jbeuckm/atmega_midi_SP0256-AL2/panel/speech_synth_panel.dxf

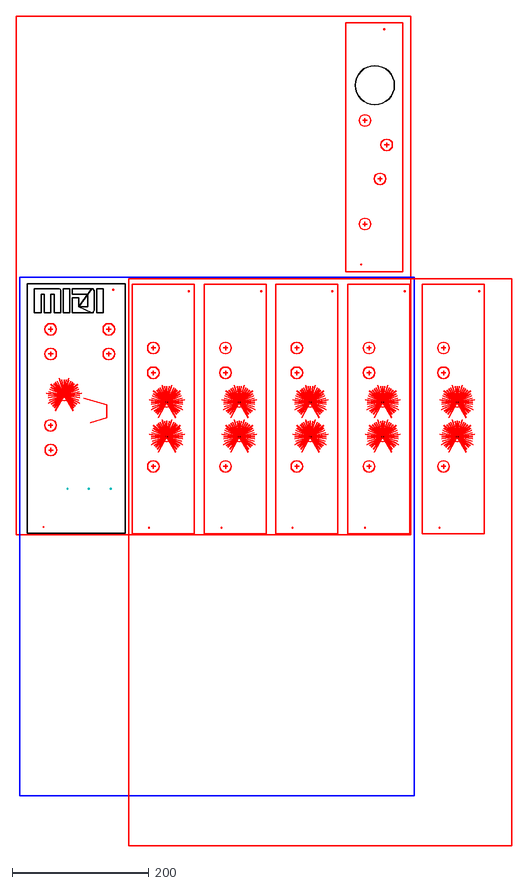
[picture p2: CAD file, 2016-11-26]
panel/speech_synth_panel.dxf
723.2 x 1211.1
