jbeuckm/atmega_midi_SP0256-AL2/panel/speech_synth_panel.pdf

# Speech

# gate

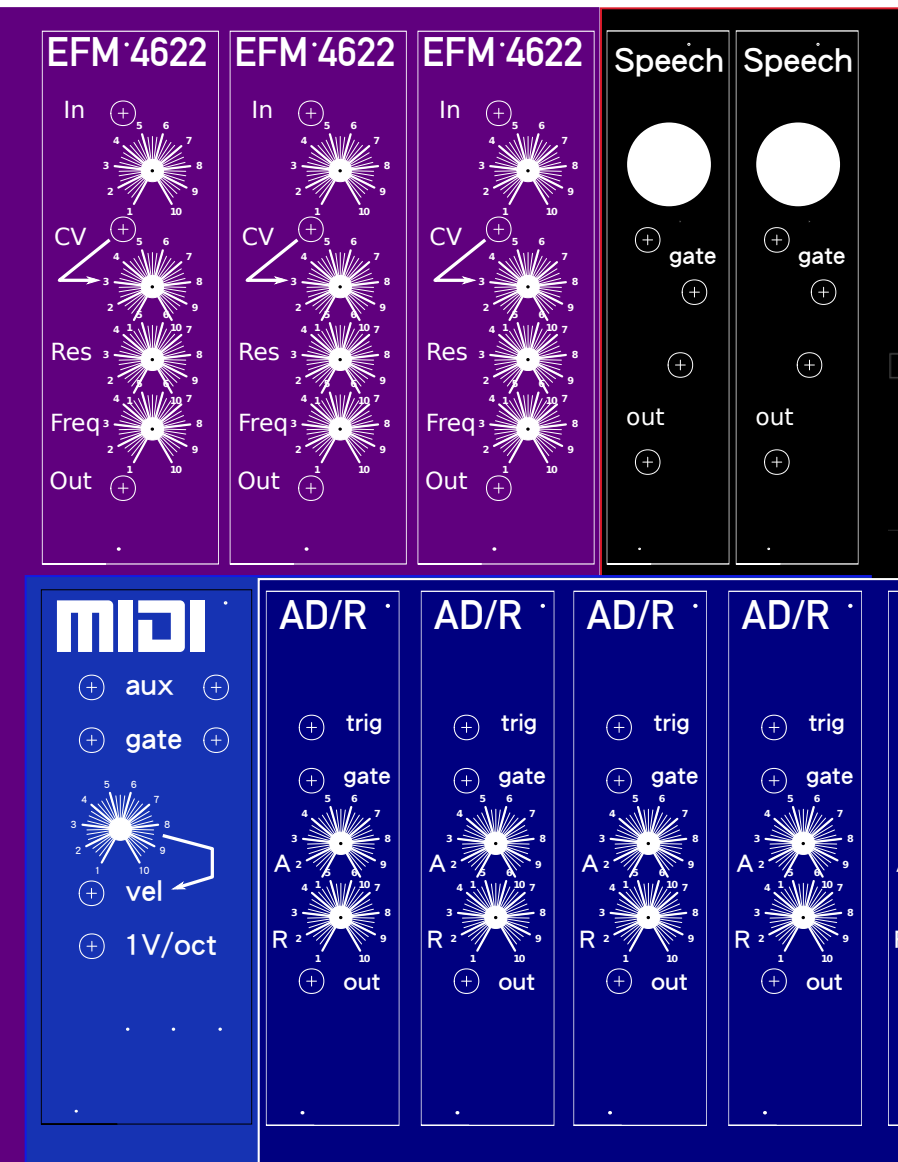
[picture p3: page 1]
out; vel; 1V/oct; gate; aux; trig; EFM 4622; Out; Res; Freq; Speech
