jbeuckm/atmega_midi_SP0256-AL2/eagle/atmega_midi_SP0256-AL2.brd

## EAGLE design eagle/atmega_midi_SP0256-AL2.brd (2016-11-26)

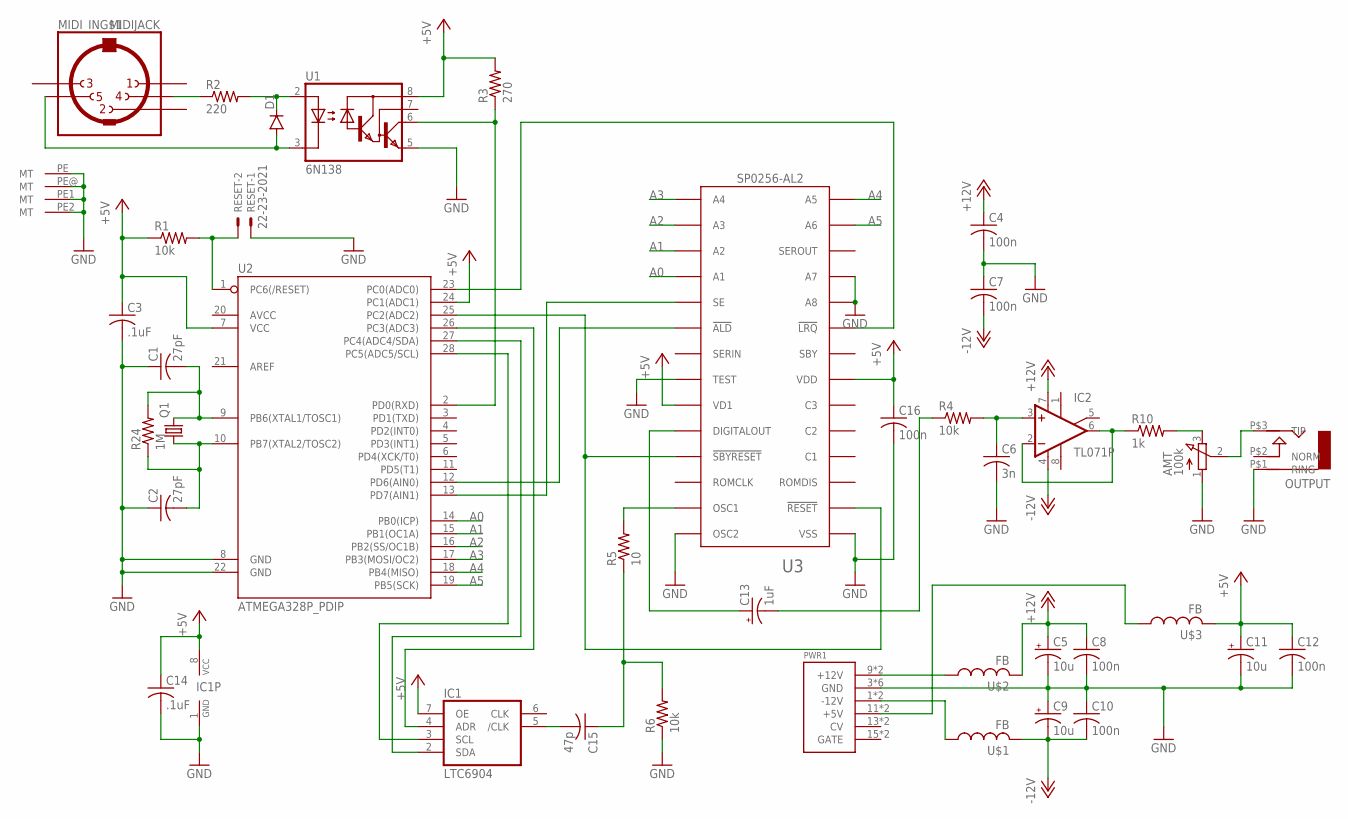
[picture p4: schematic atmega_midi_SP0256-AL2.sch]

Parts:
AMT: 100k; 3RP/1610N
C1, C2: 27pF; C025-040X050
C3, C14: .1uF; C025-030X050
C4: 100n; C050-024X044
C5, C9, C11: 10u; B45181A
C6: 3n; C050-024X044
C7, C8, C10, C12, C16: 100n; C025-030X050
C13: 1uF; E15-6
C15: 47p; C050-024X044
D1: DIODE1N4148; DIODE-1N4148
IC1: LTC6904; DIL08
IC2: TL071P; DIL08
MIDI_IN: MIDIJACK; CP-2350
OUTPUT: AUDIO-JACK; ERTHENVAR-JACK-90DEG
PWR1: POWER; POWER_16
Q1: CRYSTALHC49S; HC49/S
R1, R4, R6: 10k; 0207/7
R2: 220; 0207/7
R3: 270; 0207/7
R5: 10; 0207/7
R10: 1k; 0207/7
R24: 1M; 0207/7
RESET: 22-23-2021
U1: 6N138; DIL08
U2: ATMEGA328P_PDIP; DIL28-3
U3: SP0256-AL2; DIL28-6
U$1, U$2, U$3: FB

Connections:
+5V: C3.1, C11.+, C12.1, C14.1, C16.1, IC1.7 (OE), IC1.8 (VCC), R1.1, R3.2, U1.8 (VCC), U2.7 (VCC), U2.24 (PC1(ADC1)), U3.P$7 (VDD), U3.P$23 (VD1), U$3.P$2 (2)
+12V: C4.1, C5.+, C8.1, IC2.7 (V+), U$2.P$2 (2)
-12V: C7.2, C9.-, C10.2, IC2.4 (V-), U$1.P$2 (2)
A0: U2.14 (PB0(ICP)), U3.P$18 (A1)
A1: U2.15 (PB1(OC1A)), U3.P$17 (A2)
A2: U2.16 (PB2(SS/OC1B)), U3.P$16 (A3)
A3: U2.17 (PB3(MOSI/OC2)), U3.P$15 (A4)
A4: U2.18 (PB4(MISO)), U3.P$14 (A5)
A5: U2.19 (PB5(SCK)), U3.P$13 (A6)
GND: AMT.1 (A), C1.1, C2.1, C3.2, C4.2, C5.-, C6.2, C7.1, C8.2, C9.+, C10.1, C11.-, C12.2, C14.2, C16.2, IC1.1 (GND), MIDI_IN.PE (MT), MIDI_IN.PE1 (MT), MIDI_IN.PE2 (MT), MIDI_IN.PE@ (MT), OUTPUT.P$1 (RING), PWR1.3 (GND), PWR1.4 (GND), PWR1.5 (GND), PWR1.6 (GND), PWR1.7 (GND), PWR1.8 (GND), R6.1, RESET.1, U1.5 (GND), U2.8 (GND), U2.22 (GND), U3.P$1 (VSS), U3.P$10 (A8), U3.P$11 (A7), U3.P$22 (TEST), U3.P$28 (OSC2)
unnamed: U2.25 (PC2(ADC2)), U3.P$2 (!RESET), U3.P$25 (!SBYRESET)
unnamed: PWR1.11 (+5V), PWR1.12 (+5V), U$3.P$1 (1)
unnamed: D1.A, MIDI_IN.5, U1.3 (C)
unnamed: C1.2, Q1.2, R24.2, U2.9 (PB6(XTAL1/TOSC1))
unnamed: C2.2, Q1.1, R24.1, U2.10 (PB7(XTAL2/TOSC2))
unnamed: C6.1, IC2.3 (+IN), R4.2
unnamed: D1.C, R2.2, U1.2 (A)
unnamed: MIDI_IN.4, R2.1
unnamed: AMT.3 (E), R10.2
unnamed: U2.12 (PD6(AIN0)), U3.P$20 (!ALD)
unnamed: PWR1.9 (+12V), PWR1.10 (+12V), U$2.P$1 (1)
unnamed: IC2.2 (-IN), IC2.6 (OUT), R10.1
unnamed: AMT.2 (S), OUTPUT.P$3 (TIP)
unnamed: PWR1.1 (-12V), PWR1.2 (-12V), U$1.P$1 (1)
unnamed: IC1.3 (SCL), U2.28 (PC5(ADC5/SCL))
unnamed: U2.13 (PD7(AIN1)), U3.P$19 (SE)
unnamed: C13.+, U3.P$24 (DIGITALOUT)
unnamed: IC1.2 (SDA), U2.27 (PC4(ADC4/SDA))
unnamed: IC1.4 (ADR), U2.26 (PC3(ADC3))
unnamed: U2.23 (PC0(ADC0)), U3.P$9 (!LRQ)
unnamed: C15.2, IC1.5 (/CLK)
unnamed: R3.1, U1.6 (VO), U2.2 (PD0(RXD))
unnamed: C13.-, R4.1
unnamed: R5.2, U3.P$27 (OSC1)
unnamed: C15.1, R5.1, R6.2
unnamed: R1.2, RESET.2, U2.1 (PC6(/RESET))

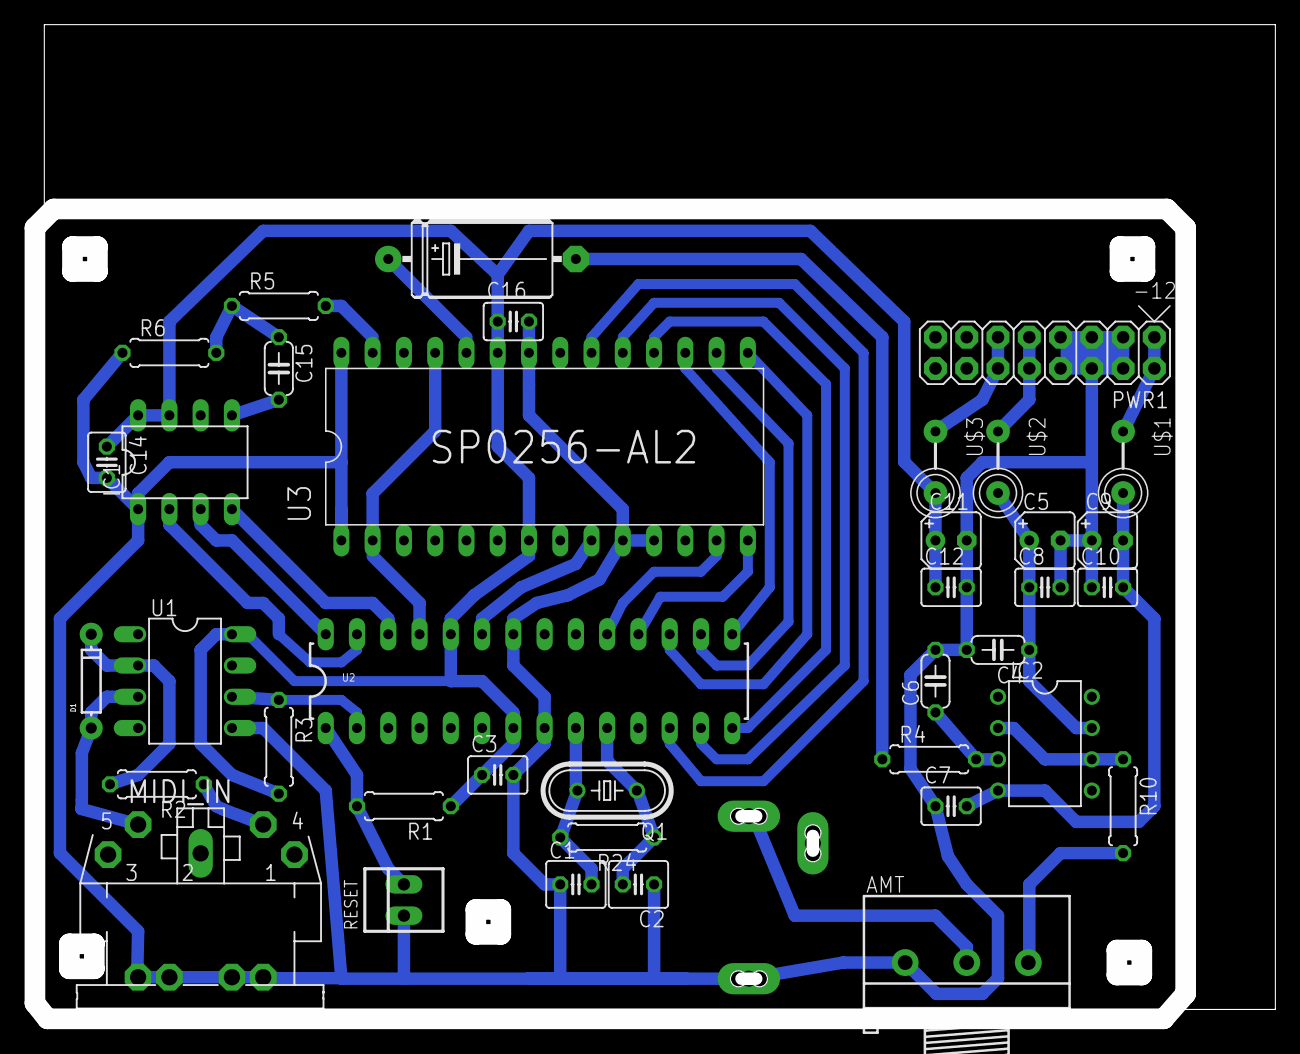
[picture p5: board atmega_midi_SP0256-AL2.brd from above]

Board: 2 copper layers, 100.8 x 80.8 mm, 39 parts (0 on the bottom side), 36 nets.
