jbeuckm/atmega_midi_SP0256-AL2/atmega_midi_sp0256/SP0256.cpp

#include "Arduino.h"
#include "SP0256.h"

/* some words to say
byte purple[] = {PP, ER1, PP, LL };
byte monkey[] = {MM, AX, NN1, KK1, IY };
byte garden[] = {GG1, AR, PA3, DD2, IH, NN1 };
byte moment[] = {MM, OW, MM, EH, NN1, TT2 };
*/

SP0256::SP0256(int aldPin, int lrqPin, int sePin, int resetPin) {
    
    PIN_ALD = aldPin;
    PIN_LRQ = lrqPin;
    PIN_SE = sePin;
    PIN_RESET = resetPin;
    
  // Set pin modes
  pinMode( PIN_ALD, OUTPUT );
  pinMode( PIN_SE, OUTPUT );
  pinMode( PIN_RESET, OUTPUT );
    
  pinMode( PIN_LRQ, INPUT );
    
  DDRB = B00111111;  // Sets PORTB pins 0-5 to output

  digitalWrite(PIN_ALD, HIGH);
  digitalWrite(PIN_SE, HIGH);
  
/*
  speak( purple, (byte)(sizeof(purple) / sizeof(byte)) );
  speak( monkey, (byte)(sizeof(monkey) / sizeof(byte)) );
  speak( garden, (byte)(sizeof(garden) / sizeof(byte)) );
  speak( moment, (byte)(sizeof(moment) / sizeof(byte)) );
  */
}


void SP0256::speakList( byte* allophones, byte count ) {
  for( byte b = 0; b < count; b++ ) {
    speak( allophones[b] );
  }
}

void SP0256::speak( byte allophone ) {
   while ( digitalRead(PIN_LRQ) == HIGH ); // Wait for LRQ to go low

  PORTB = allophone; // select the allophone

  // Tell it to speak by toggling ALD
  digitalWrite(PIN_ALD, LOW);
  digitalWrite(PIN_ALD, HIGH);
}


void SP0256::reset() {
  digitalWrite(PIN_RESET, LOW);
  delayMicroseconds(10);
  digitalWrite(PIN_RESET, HIGH);
}
