jbeuckm/atmega_midi_SP0256-AL2/(commit log)

2016-09-14 mostly there with sp chip
    [atmega_midi_SP0256-AL2.sch]
2016-09-15 parts on board
    [atmega_midi_SP0256-AL2.brd]
2016-09-15 layout adjusting
    [atmega_midi_SP0256-AL2.brd, atmega_midi_SP0256-AL2.sch]
2016-09-15 93pct auto
    [atmega_midi_SP0256-AL2.brd, atmega_midi_SP0256-AL2.sch]
2016-09-15 first cut
2016-09-15 starting a library for controlling the sp chip
    [atmega_midi_SP0256-AL2.sch]
2016-09-15 arduino compiles
2016-09-20 gate led working but no speech yet
2016-09-20 schematic corrected for reset control
    [atmega_midi_SP0256-AL2.brd, atmega_midi_SP0256-AL2.sch]
2016-09-20 board corrected for reset control
    [atmega_midi_SP0256-AL2.brd, atmega_midi_SP0256-AL2.sch]
2016-09-21 adding allophone list class
    [atmega_midi_SP0256-AL2.brd]
2016-09-21 reset at beginning of each speakList()
    [SP0256.cpp]
2016-09-21 assign sysex speak word to current note
2016-09-21 gate led while sysex speak word
2016-11-26 panel and working cut
    [basic_midi_cv_panel.dxf, speech_synth_panel.dxf]
2016-11-26 added ltc6904
    [atmega_midi_SP0256-AL2.brd, atmega_midi_SP0256-AL2.sch]
2016-11-26 renamed arduino code file and new board taking shape
    [atmega_midi_SP0256-AL2.brd, atmega_midi_SP0256-AL2.sch]
2016-11-26 routed and stub code for pitch oscillator
    [atmega_midi_SP0256-AL2.brd, atmega_midi_SP0256-AL2.sch]
2016-11-27 LTC interface and no gate led or out
2016-11-27 listening for baseChannel + 1 to set pitch
